aristokant2027/bot/docs/preview_three_quarter.png

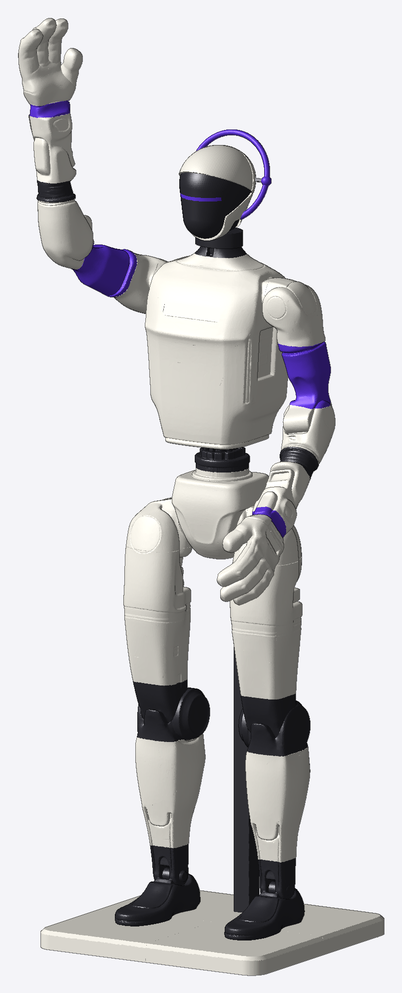
docs/preview_three_quarter.png
