aristokant2027/bot/stl/1_white/head_cheek.stl

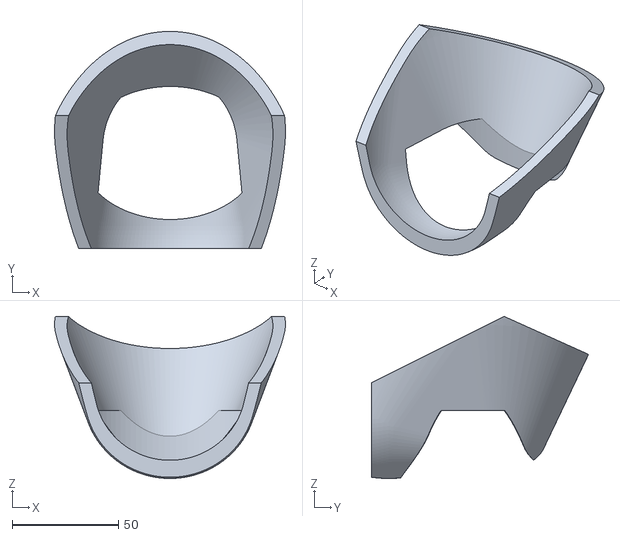
[picture p5: CAD file, 2026-11-12]
stl/1_white/head_cheek.stl
108.7 x 102.2 x 76.3
