aristokant2027/bot/stl/2_black/head.stl

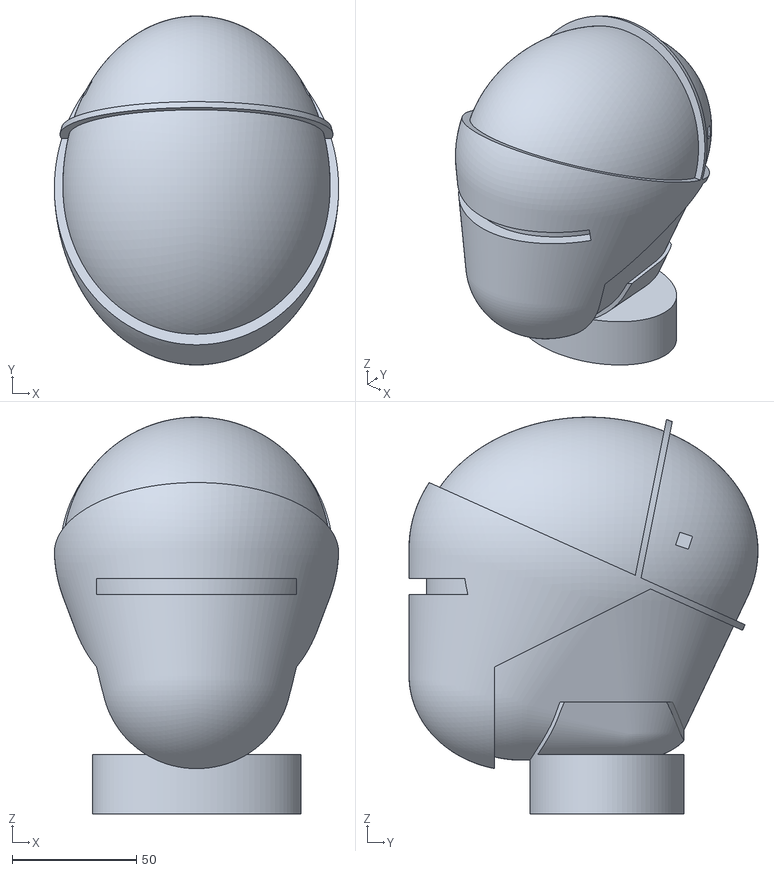
[picture p6: CAD file, 2026-11-12]
stl/2_black/head.stl
114.5 x 140.5 x 159.8
