aristokant2027/bot/stl/3_purple/head_eye.stl

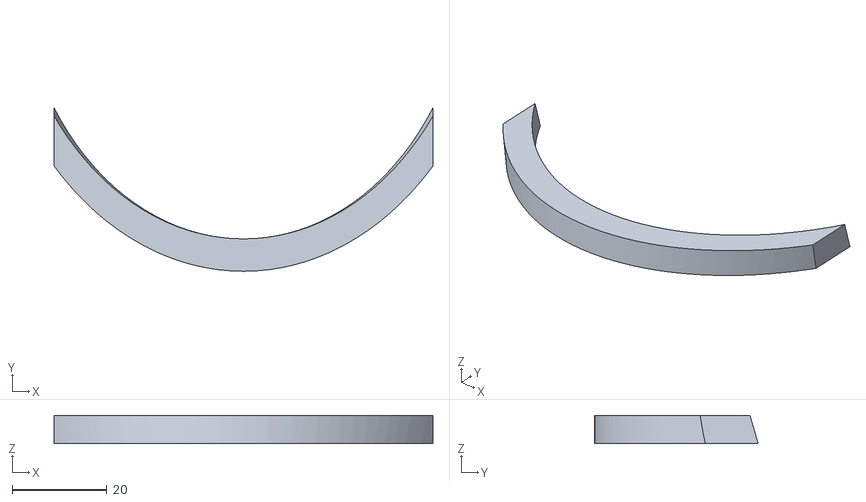
[picture p7: CAD file, 2026-11-12]
stl/3_purple/head_eye.stl
80.0 x 34.5 x 6.00
