aristokant2027/bot/stl/4_connectors/tenon_T16x89.stl

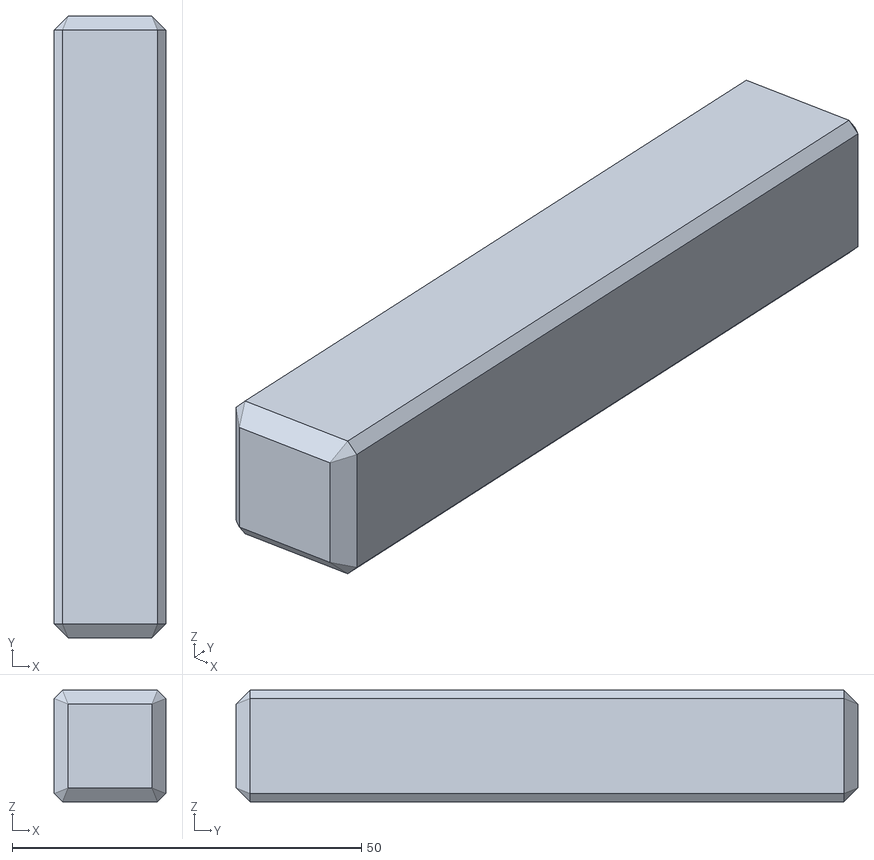
[picture p8: CAD file, 2026-11-12]
stl/4_connectors/tenon_T16x89.stl
16.0 x 89.0 x 16.0
