aristokant2027/bot/stl/1_white/head_cap_f.stl

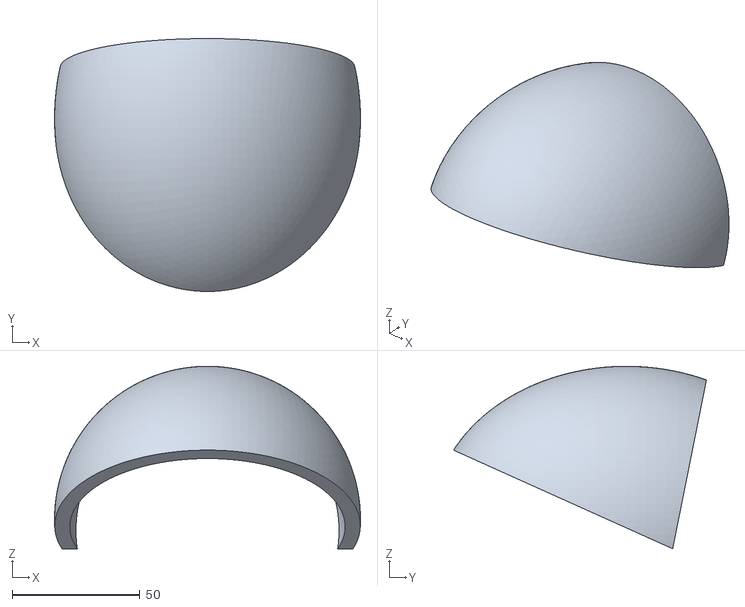
[picture p9: CAD file, 2026-11-12]
stl/1_white/head_cap_f.stl
120.0 x 99.2 x 71.6
