aristokant2027/bot/stl/2_black/halo_strut_L.stl

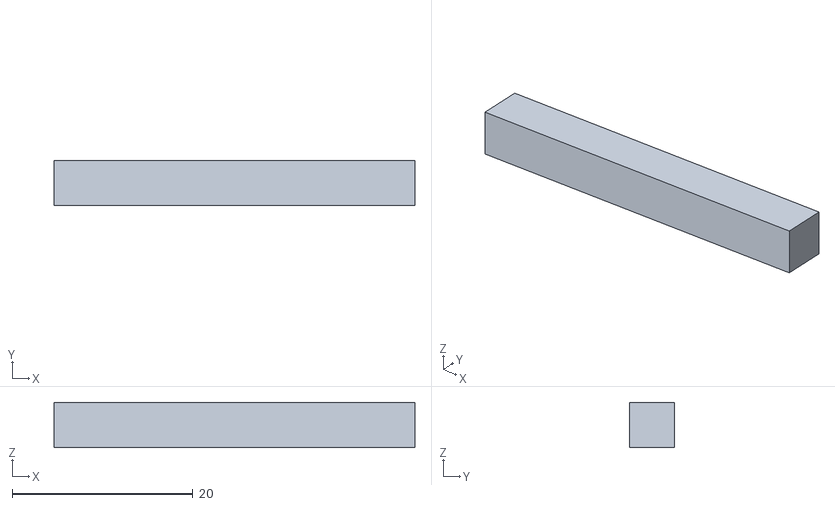
[picture p10: CAD file, 2026-11-12]
stl/2_black/halo_strut_L.stl
40.0 x 5.00 x 5.00
