aristokant2027/bot/stl/3_purple/halo.stl

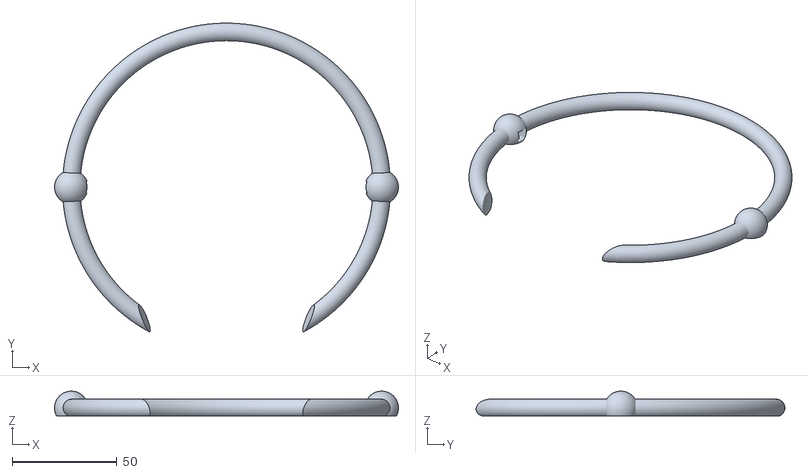
[picture p11: CAD file, 2026-11-12]
stl/3_purple/halo.stl
164.0 x 147.2 x 11.8
