aristokant2027/bot/stl/4_connectors/fit_test_coupon.stl

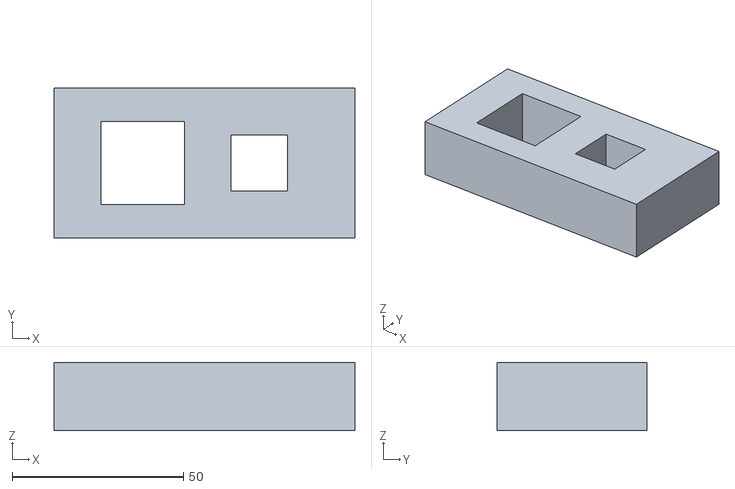
[picture p12: CAD file, 2026-11-11]
stl/4_connectors/fit_test_coupon.stl
88.0 x 44.0 x 20.0
