aristokant2027/bot/stl/1_white/head_cap_r.stl

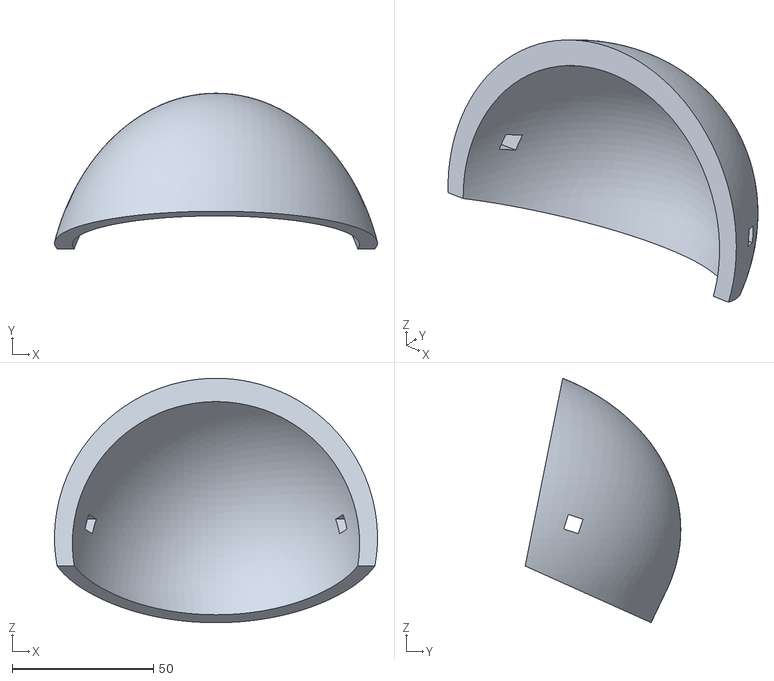
[picture p13: CAD file, 2026-11-12]
stl/1_white/head_cap_r.stl
114.2 x 55.0 x 86.4
