aristokant2027/bot/stl/3_purple/sleeve_L.stl

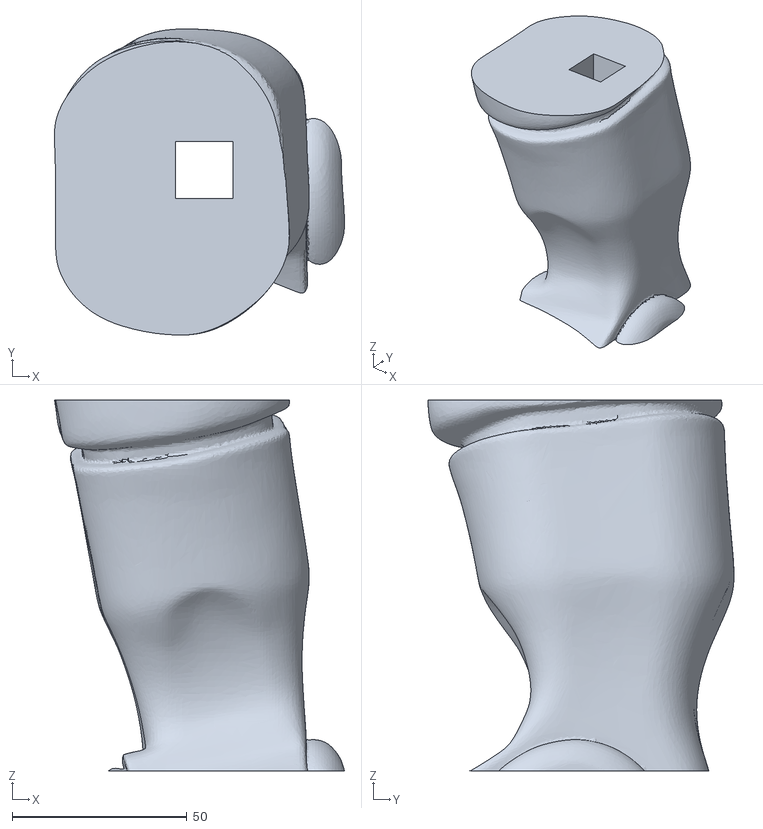
[picture p14: CAD file, 2026-11-11]
stl/3_purple/sleeve_L.stl
82.9 x 87.5 x 106.0
