aristokant2027/bot/stl/4_connectors/tenon_T16x76.stl

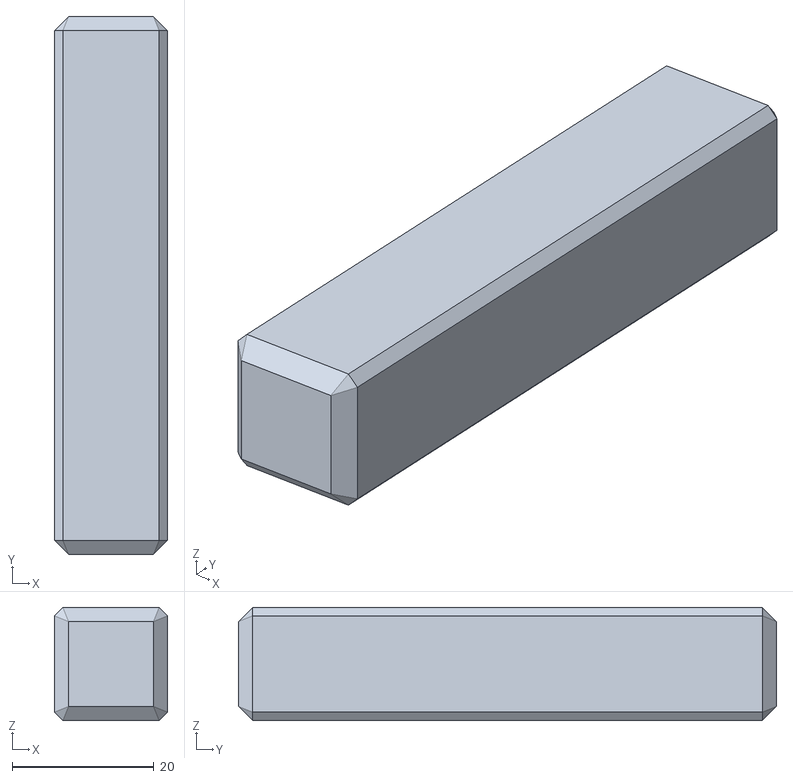
[picture p15: CAD file, 2026-11-11]
stl/4_connectors/tenon_T16x76.stl
16.0 x 76.0 x 16.0
