aristokant2027/bot/stl/1_white/torso.stl

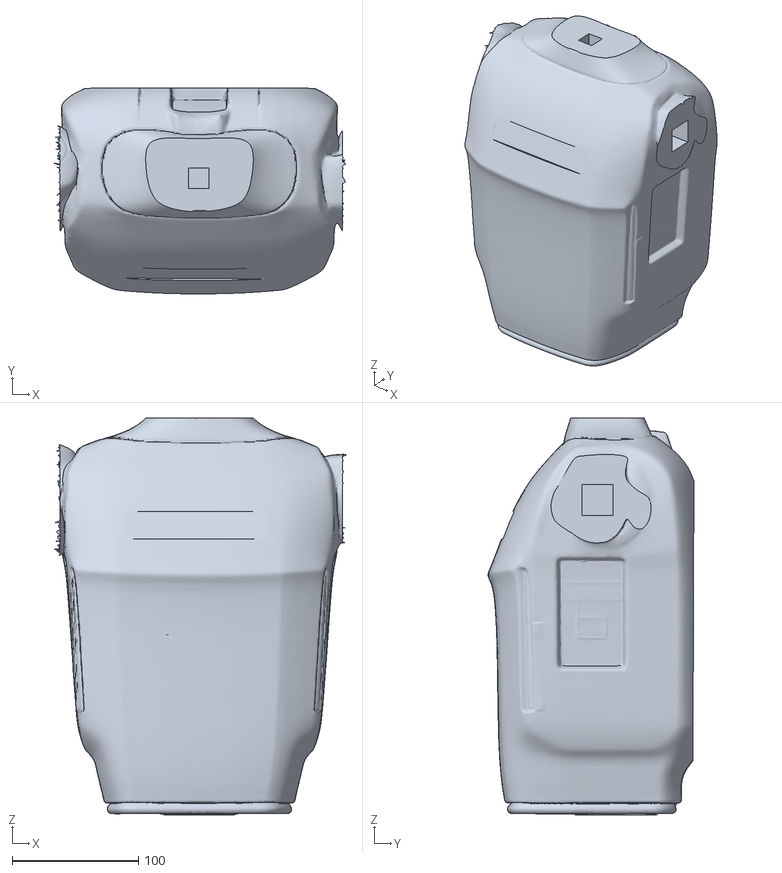
[picture p16: CAD file, 2026-11-12]
stl/1_white/torso.stl
231.3 x 163.4 x 315.0
