aristokant2027/bot/stl/2_black/neck.stl

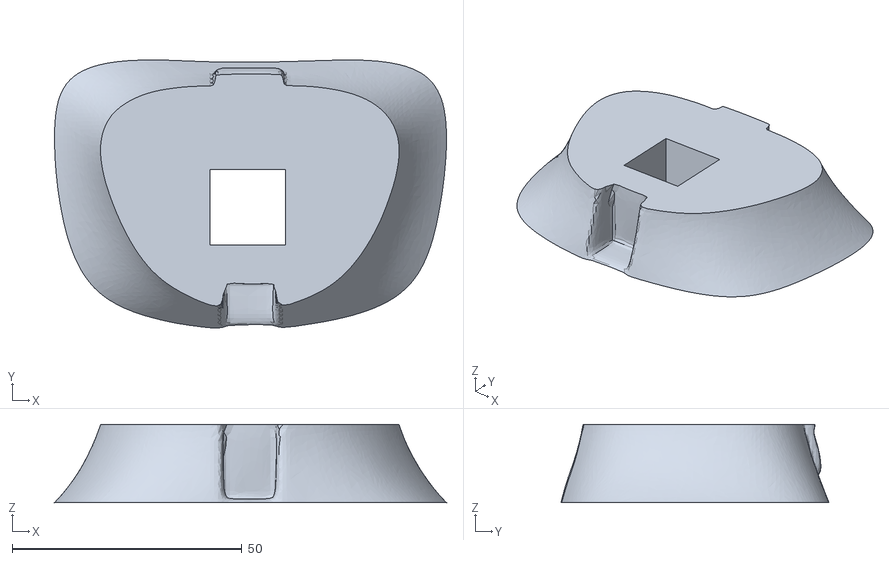
[picture p17: CAD file, 2026-11-12]
stl/2_black/neck.stl
85.4 x 58.4 x 17.0
