aristokant2027/bot/stl/3_purple/wrist_L.stl

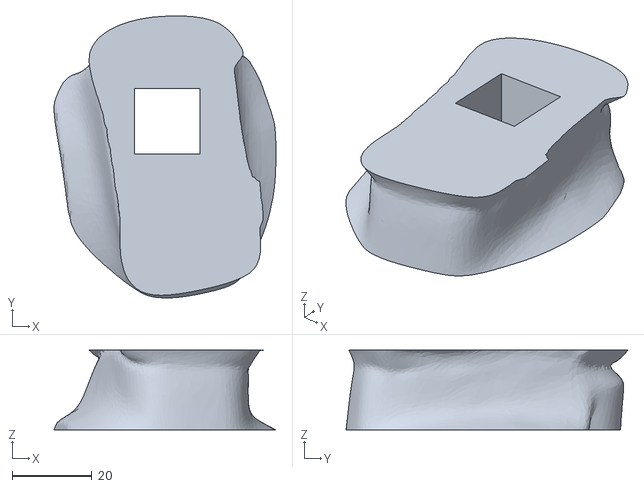
[picture p18: CAD file, 2026-11-11]
stl/3_purple/wrist_L.stl
55.5 x 70.5 x 20.0
