aristokant2027/bot/stl/4_connectors/tenon_T24x101.stl

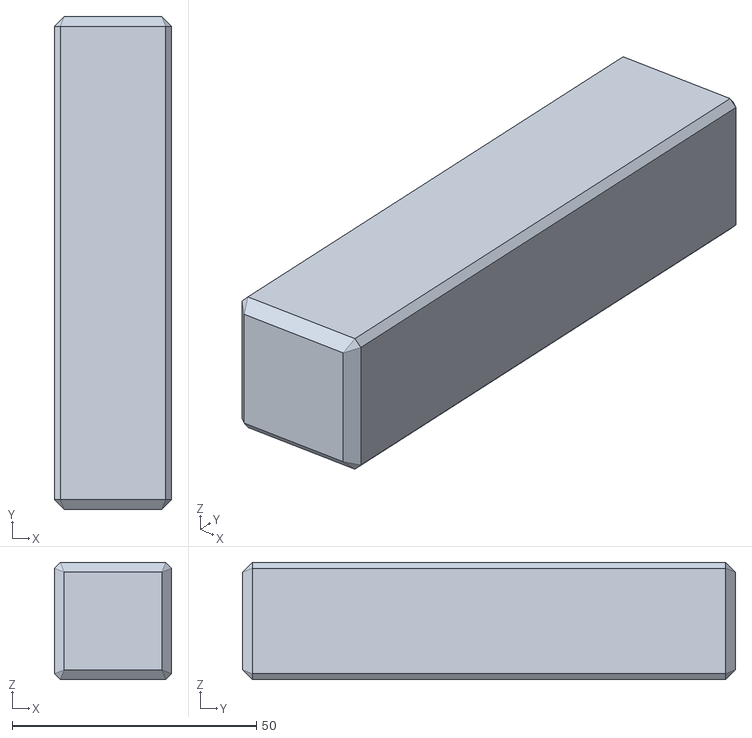
[picture p19: CAD file, 2026-11-11]
stl/4_connectors/tenon_T24x101.stl
24.0 x 101.0 x 24.0
