aristokant2027/bot/stl/1_white/pelvis.stl

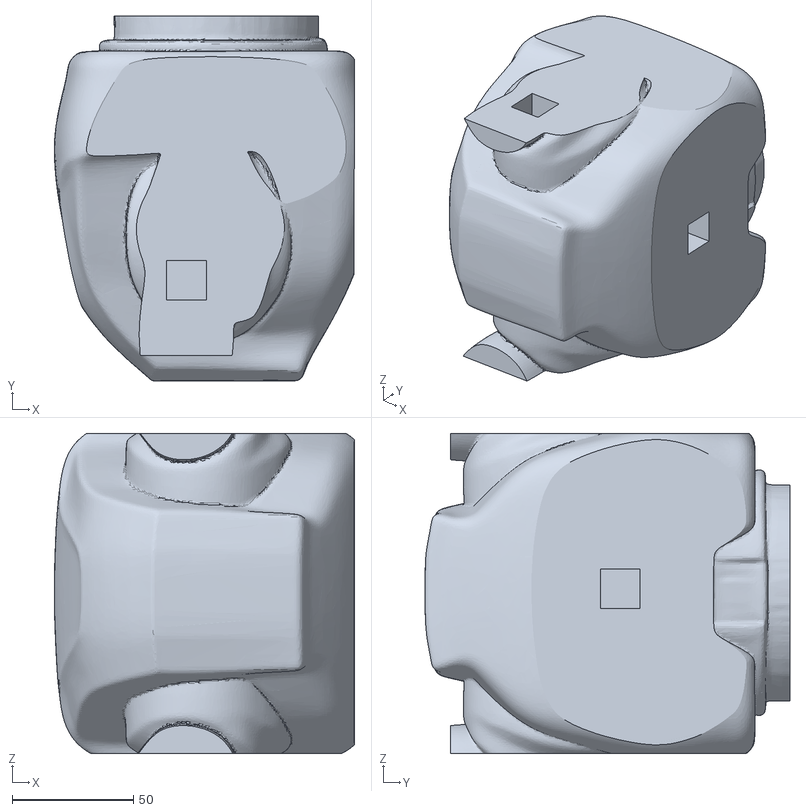
[picture p20: CAD file, 2026-11-11]
stl/1_white/pelvis.stl
123.9 x 150.6 x 132.0
