aristokant2027/bot/stl/2_black/waistcol.stl

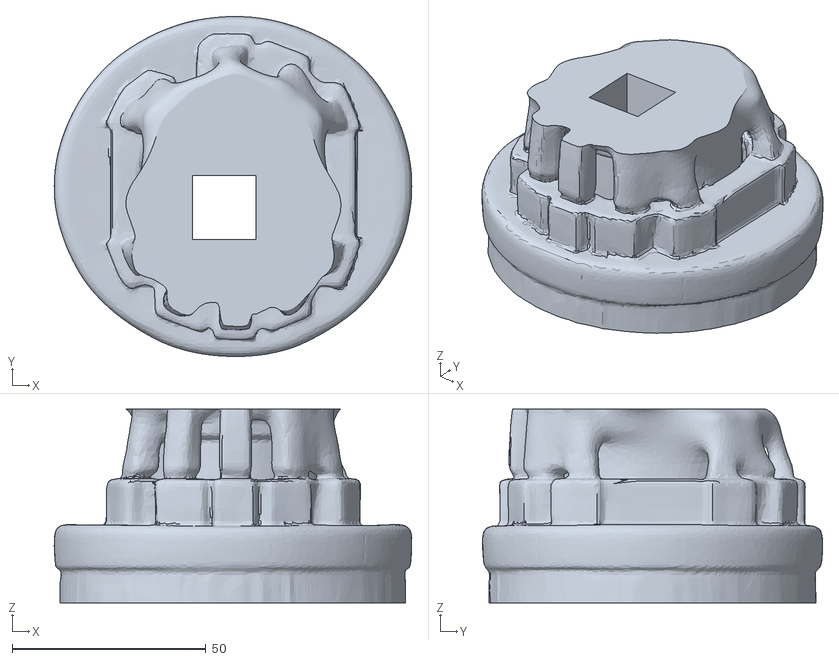
[picture p21: CAD file, 2026-11-11]
stl/2_black/waistcol.stl
92.2 x 87.7 x 50.0
