aristokant2027/bot/stl/3_purple/sleeve_R.stl

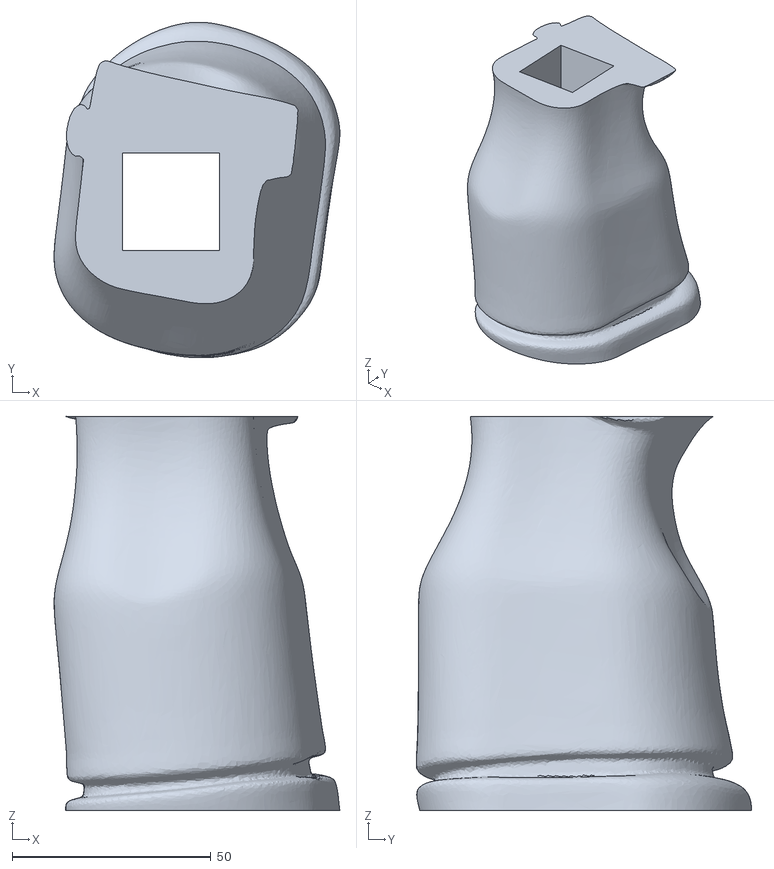
[picture p22: CAD file, 2026-11-11]
stl/3_purple/sleeve_R.stl
71.8 x 84.3 x 99.0
