aristokant2027/bot/stl/4_connectors/tenon_T24x67.stl

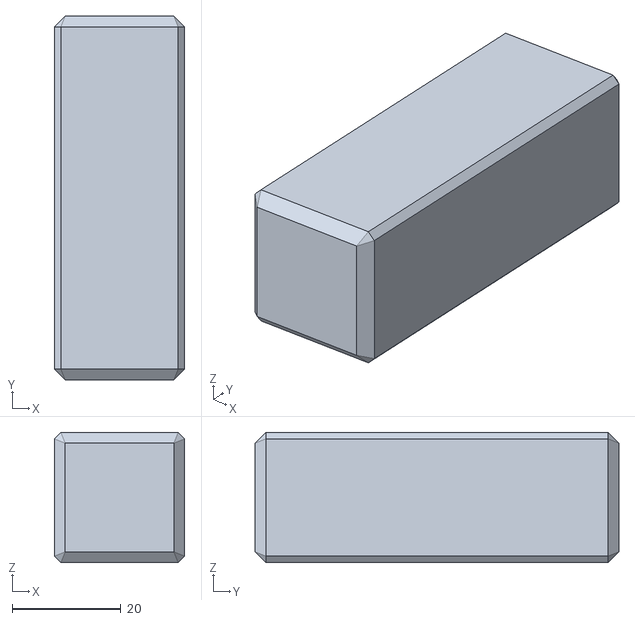
[picture p23: CAD file, 2026-11-11]
stl/4_connectors/tenon_T24x67.stl
24.0 x 67.0 x 24.0
