aristokant2027/bot/stl/1_white/hip_R.stl

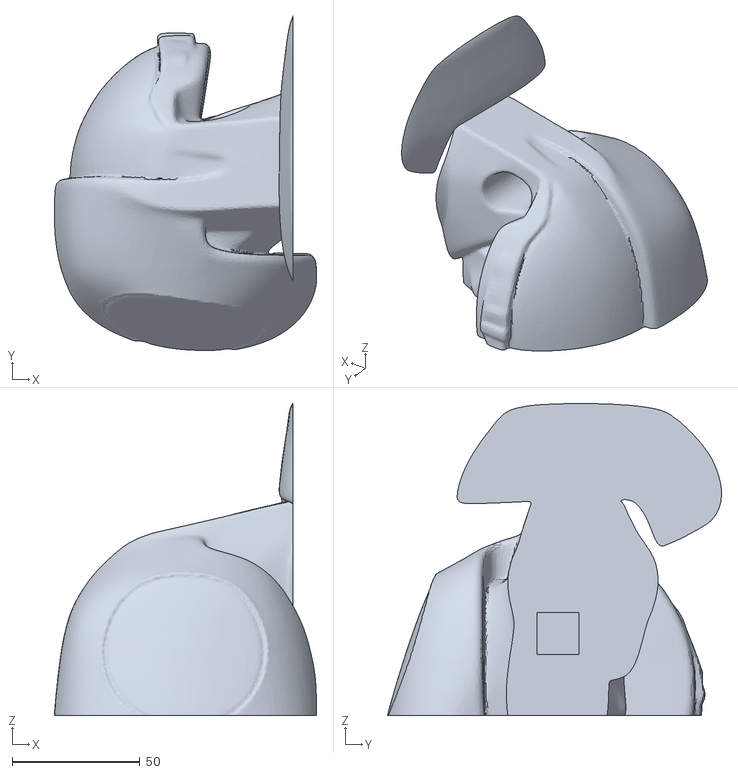
[picture p24: CAD file, 2026-11-11]
stl/1_white/hip_R.stl
102.5 x 130.6 x 122.0
