aristokant2027/bot/stl/2_black/ring_R.stl

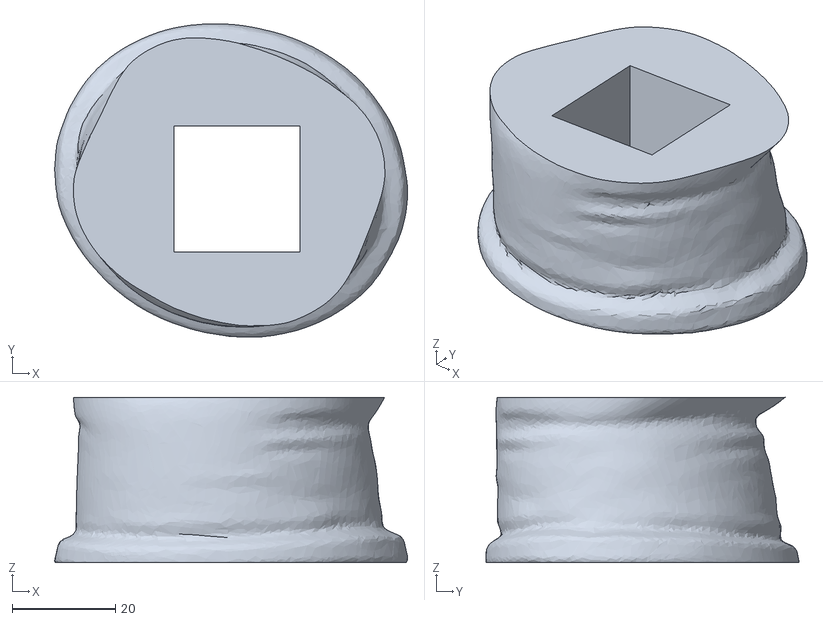
[picture p25: CAD file, 2026-11-11]
stl/2_black/ring_R.stl
68.3 x 60.7 x 32.0
