aristokant2027/bot/stl/3_purple/wrist_R.stl

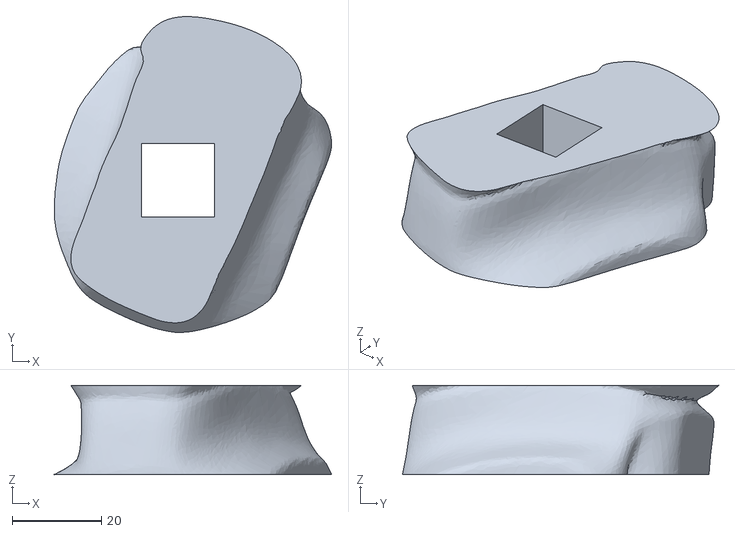
[picture p26: CAD file, 2026-11-11]
stl/3_purple/wrist_R.stl
62.2 x 70.9 x 20.0
