aristokant2027/bot/stl/4_connectors/tenon_T24x69.stl

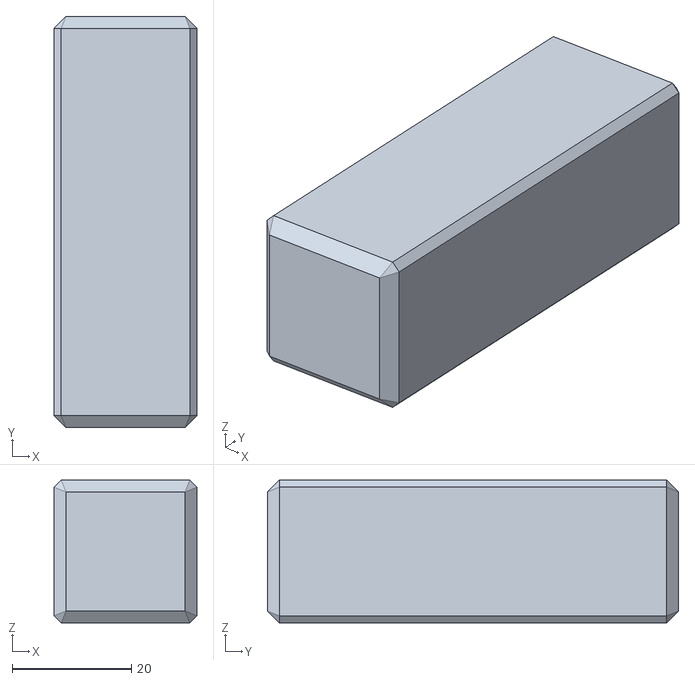
[picture p27: CAD file, 2026-11-11]
stl/4_connectors/tenon_T24x69.stl
24.0 x 69.0 x 24.0
