aristokant2027/bot/stl/1_white/thigh_R.stl

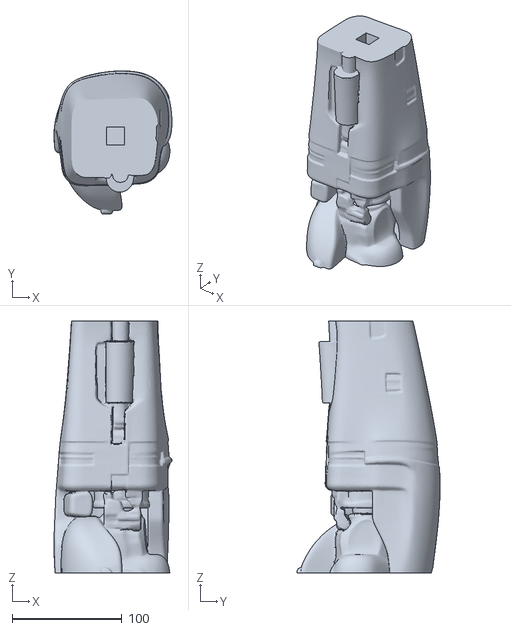
[picture p28: CAD file, 2026-11-11]
stl/1_white/thigh_R.stl
107.6 x 130.7 x 230.0
