aristokant2027/bot/stl/2_black/knee_L.stl

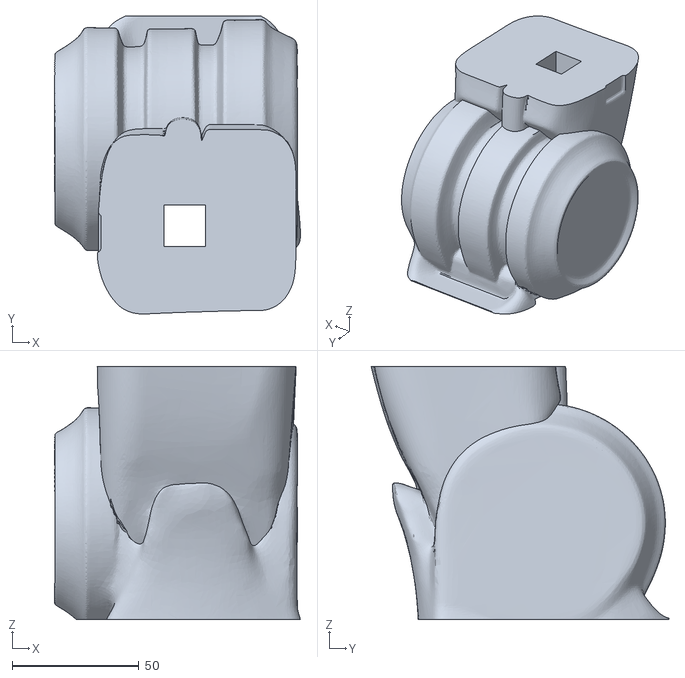
[picture p29: CAD file, 2026-11-11]
stl/2_black/knee_L.stl
97.1 x 117.6 x 100.0
