aristokant2027/bot/stl/4_connectors/tenon_T16x44.stl

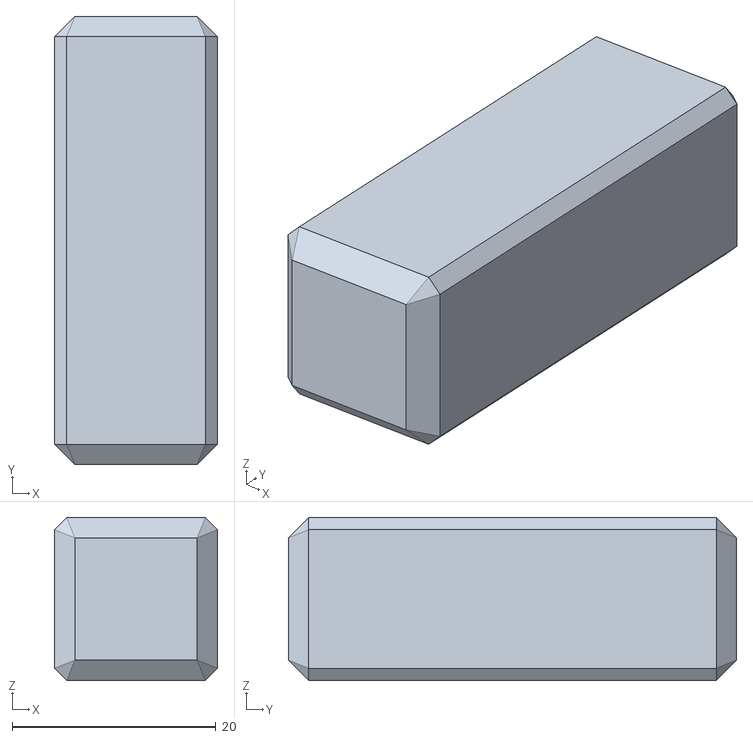
[picture p30: CAD file, 2026-11-11]
stl/4_connectors/tenon_T16x44.stl
16.0 x 44.0 x 16.0
