aristokant2027/bot/stl/1_white/shoulder_L.stl

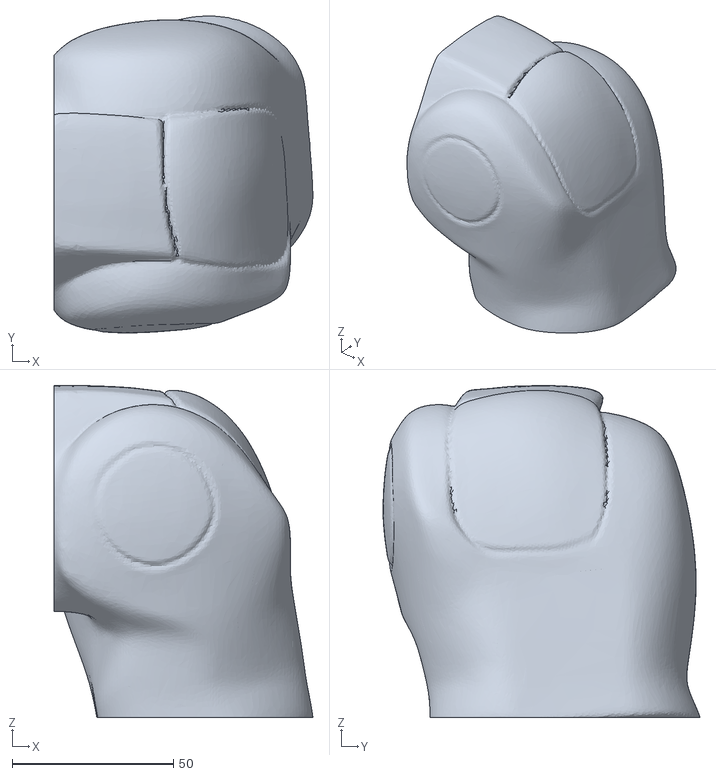
[picture p31: CAD file, 2026-11-11]
stl/1_white/shoulder_L.stl
80.3 x 98.4 x 103.1
