aristokant2027/bot/stl/2_black/post_3.stl

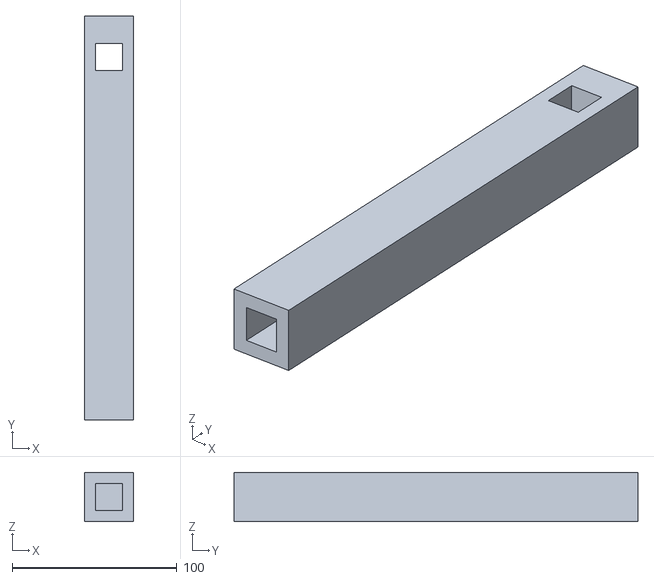
[picture p32: CAD file, 2026-11-11]
stl/2_black/post_3.stl
30.0 x 245.0 x 30.0
