aristokant2027/bot/stl/4_connectors/tenon_T16x69.stl

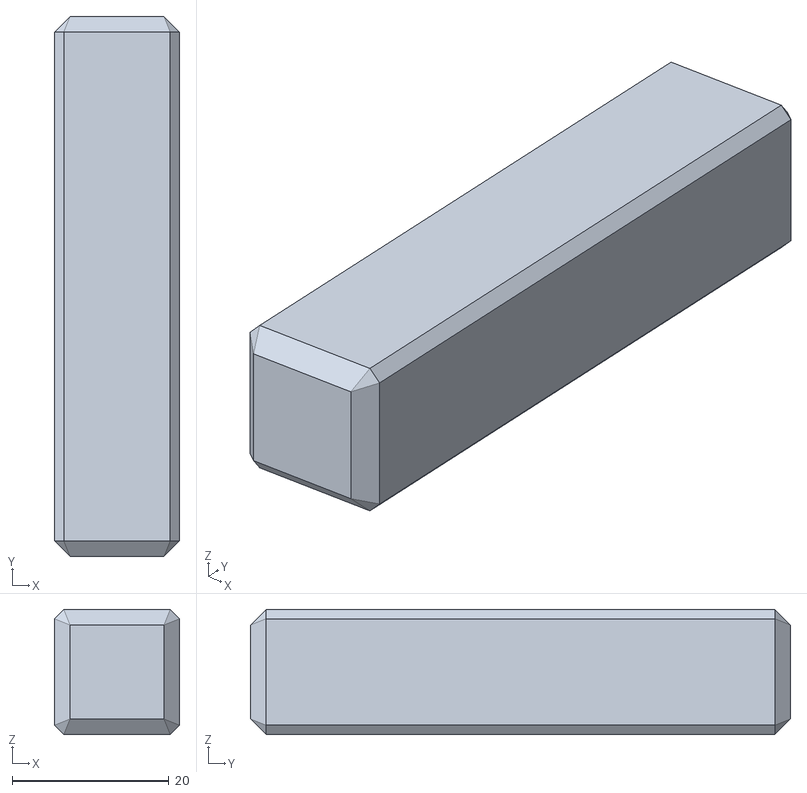
[picture p33: CAD file, 2026-11-11]
stl/4_connectors/tenon_T16x69.stl
16.0 x 69.0 x 16.0
