aristokant2027/bot/stl/1_white/elbow_R.stl

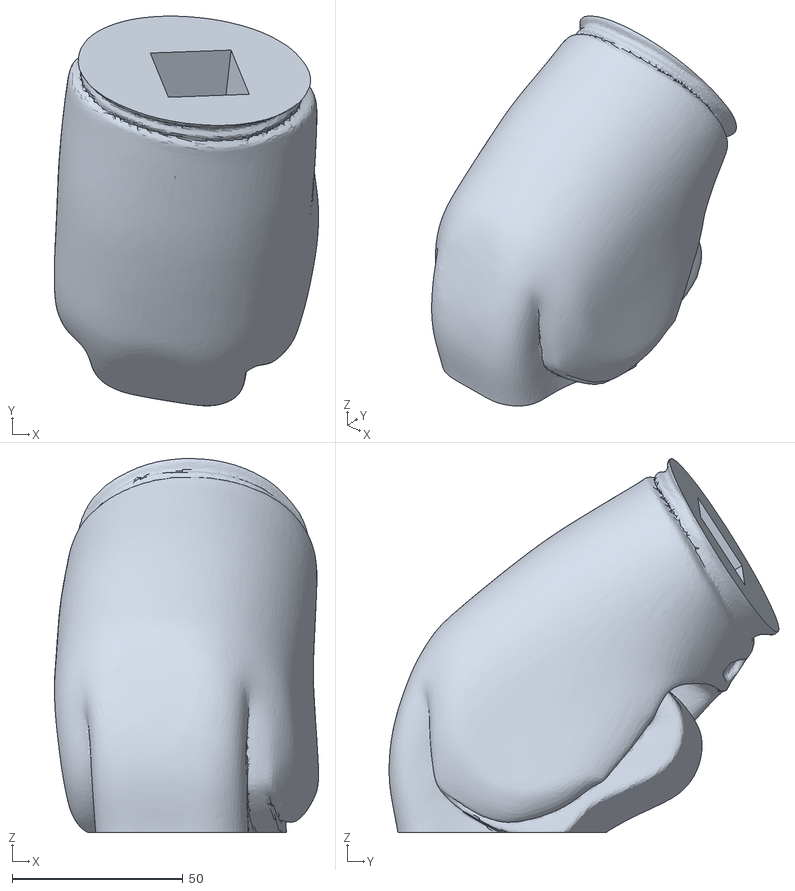
[picture p34: CAD file, 2026-11-11]
stl/1_white/elbow_R.stl
77.4 x 114.2 x 109.6
