aristokant2027/bot/stl/2_black/ring_L.stl

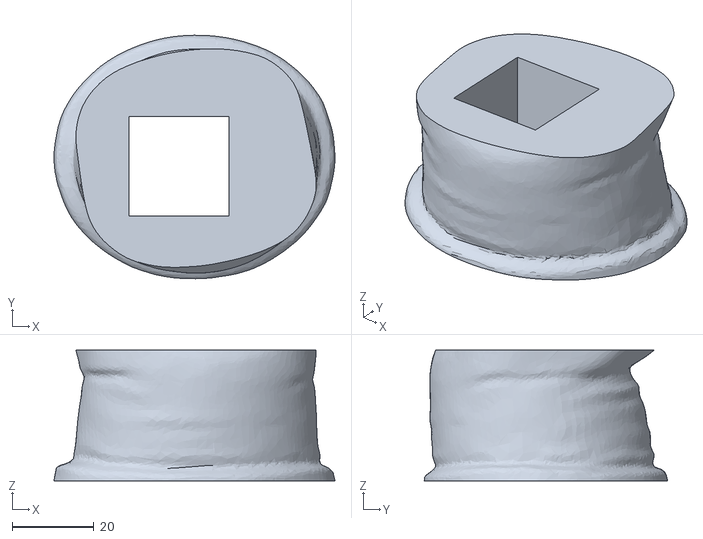
[picture p35: CAD file, 2026-11-11]
stl/2_black/ring_L.stl
68.8 x 59.6 x 32.0
