aristokant2027/bot/stl/4_connectors/bowtie_key.stl

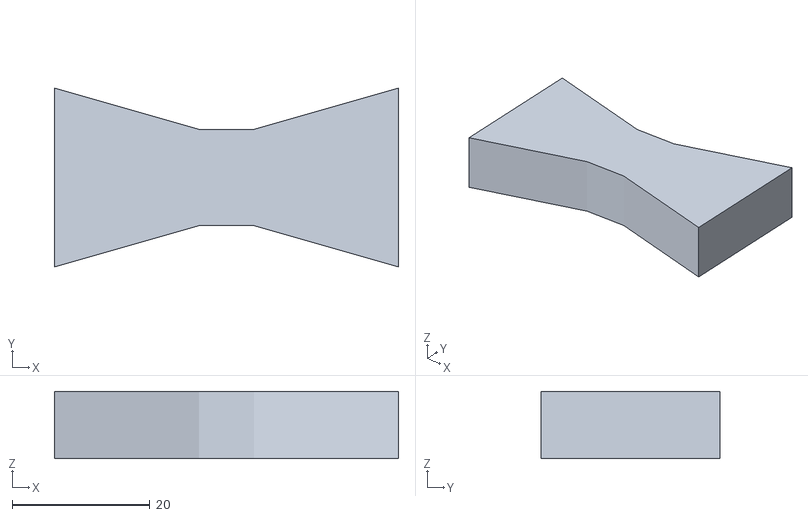
[picture p36: CAD file, 2026-11-11]
stl/4_connectors/bowtie_key.stl
50.0 x 26.0 x 9.80
