aristokant2027/bot/stl/1_white/hand_L.stl

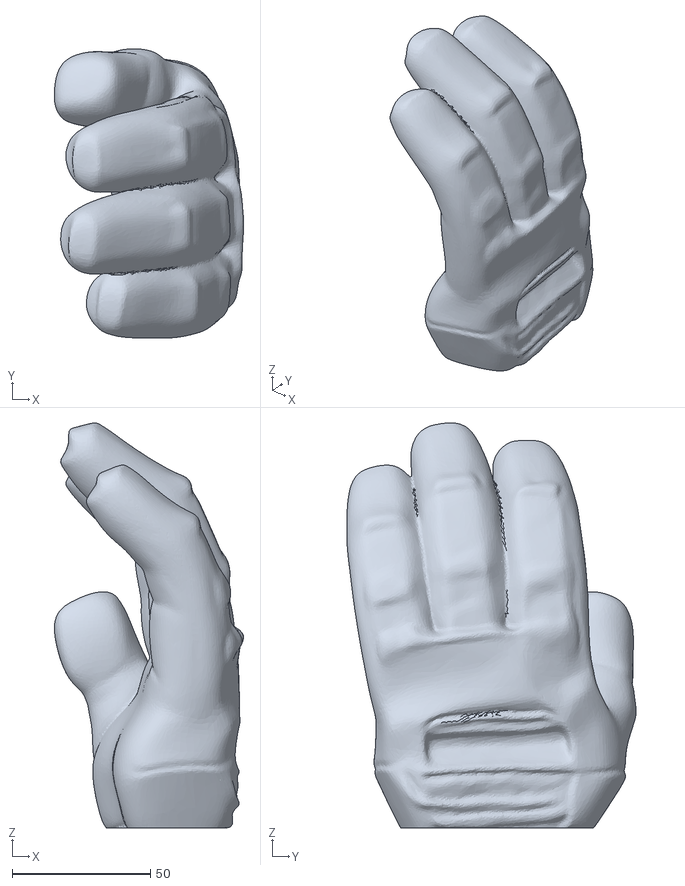
[picture p37: CAD file, 2026-11-11]
stl/1_white/hand_L.stl
68.6 x 104.8 x 146.7
