aristokant2027/bot/stl/2_black/foot_L.stl

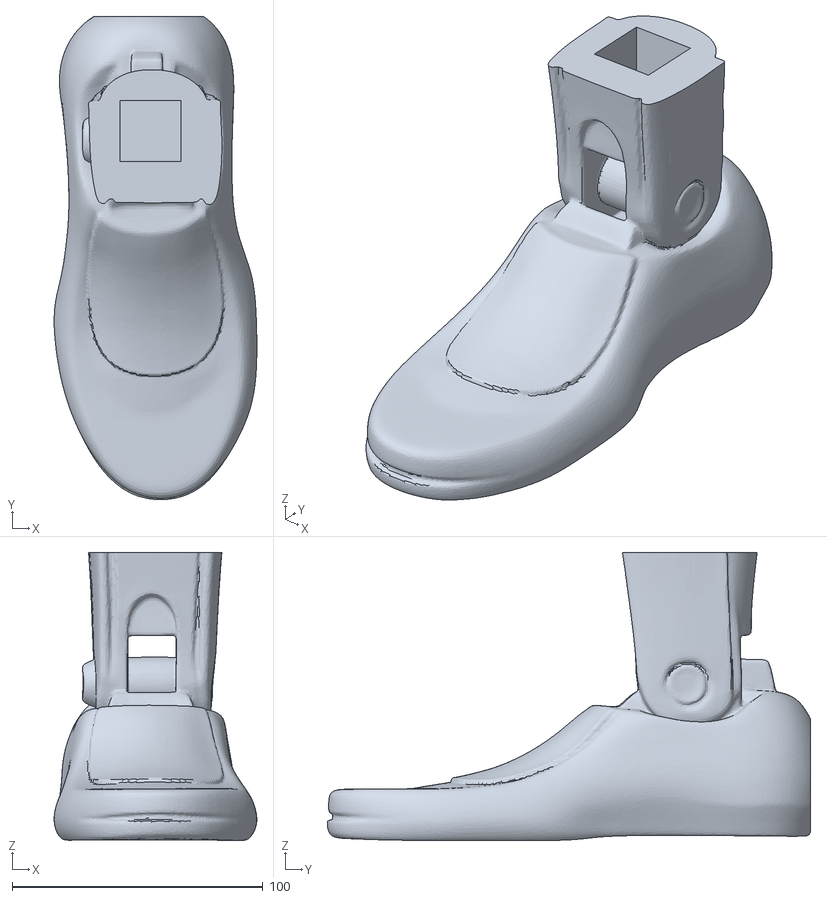
[picture p38: CAD file, 2026-11-11]
stl/2_black/foot_L.stl
80.9 x 193.0 x 115.0
