aristokant2027/bot/stl/4_connectors/tenon_T16x175.stl

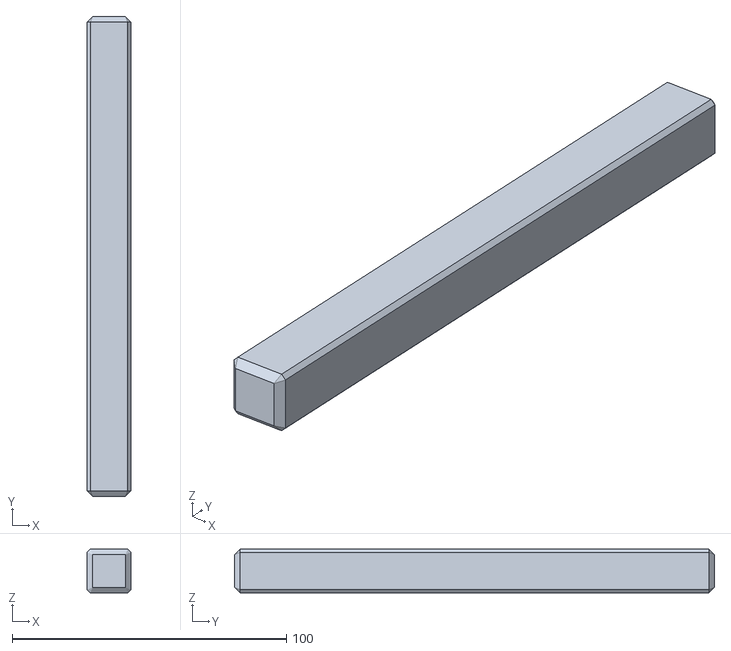
[picture p39: CAD file, 2026-11-11]
stl/4_connectors/tenon_T16x175.stl
16.0 x 175.0 x 16.0
