aristokant2027/bot/stl/1_white/shin_R.stl

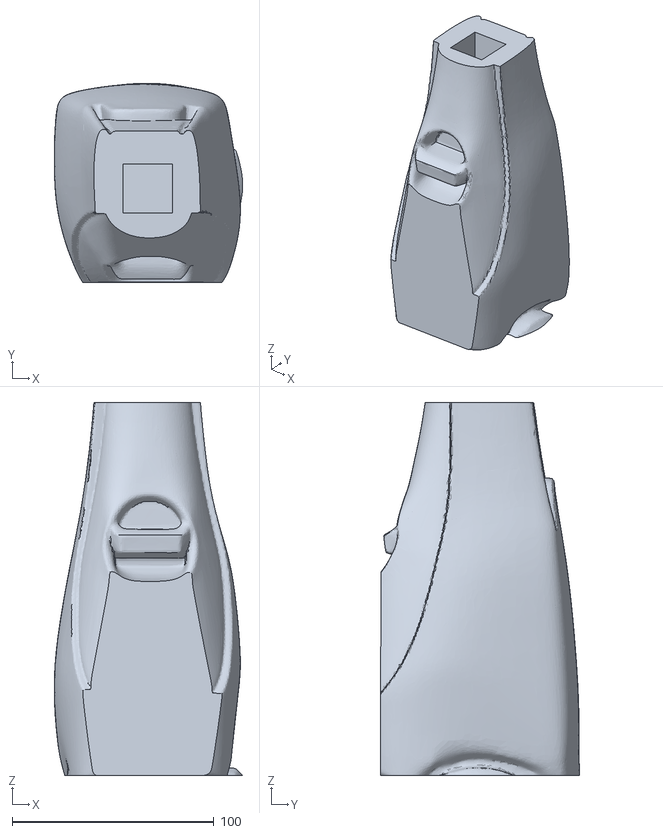
[picture p40: CAD file, 2026-11-11]
stl/1_white/shin_R.stl
93.5 x 98.9 x 185.0
