aristokant2027/bot/stl/2_black/knee_R.stl

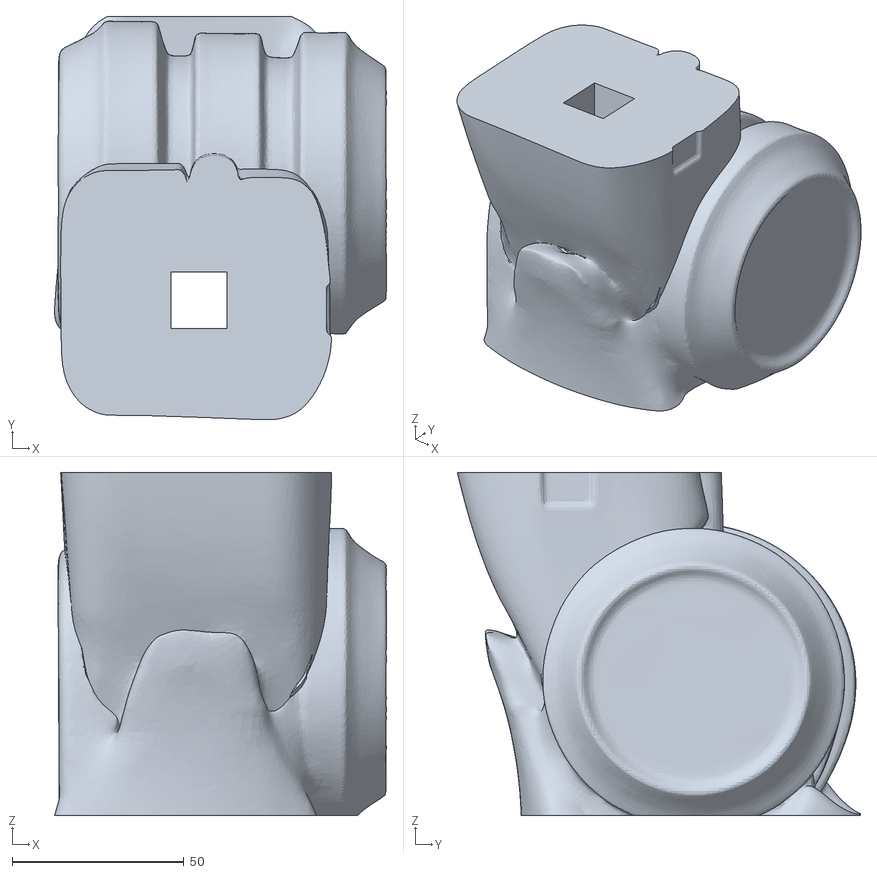
[picture p41: CAD file, 2026-11-11]
stl/2_black/knee_R.stl
96.7 x 117.5 x 100.0
