aristokant2027/bot/stl/4_connectors/tenon_T16x139.stl

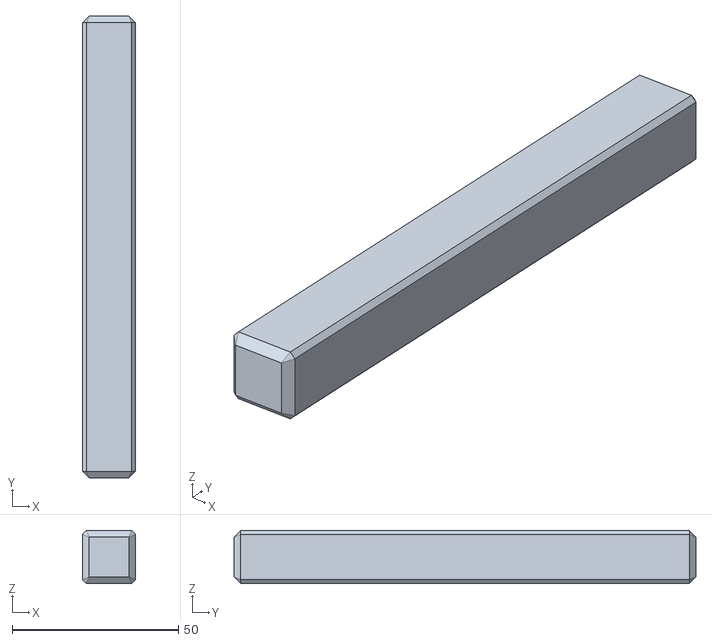
[picture p42: CAD file, 2026-11-11]
stl/4_connectors/tenon_T16x139.stl
16.0 x 139.0 x 16.0
