aristokant2027/bot/stl/1_white/forearm_L.stl

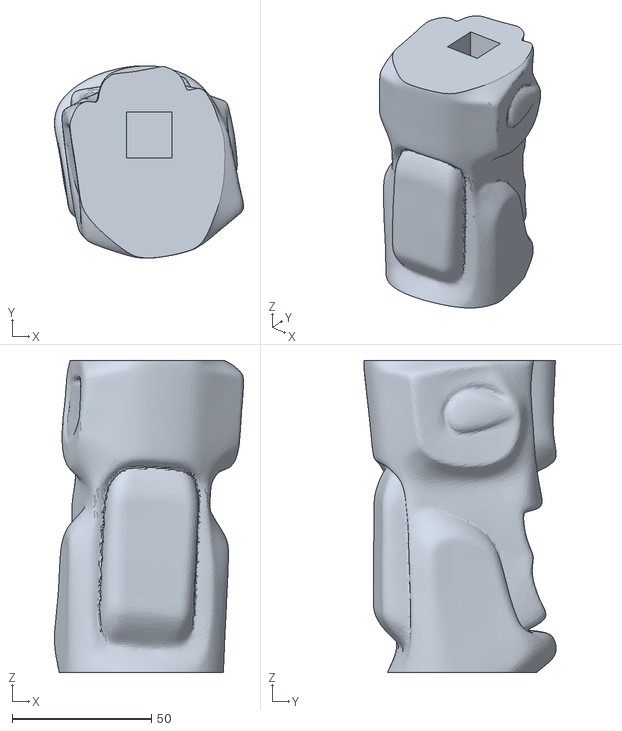
[picture p43: CAD file, 2026-11-11]
stl/1_white/forearm_L.stl
67.9 x 69.0 x 112.0
