aristokant2027/bot/stl/4_connectors/tenon_T24x168.stl

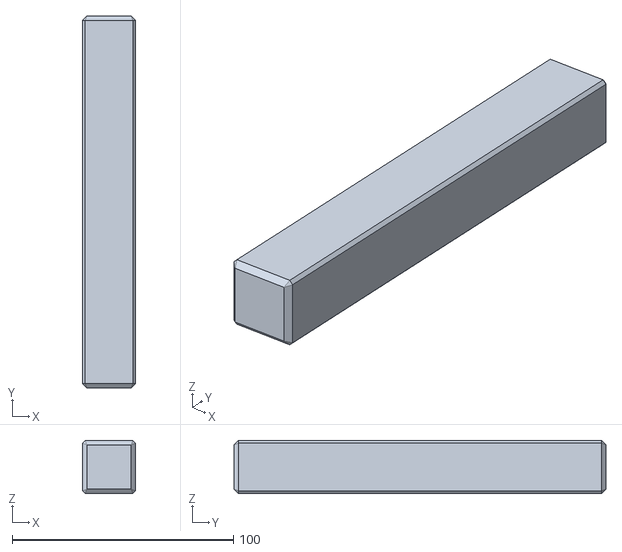
[picture p44: CAD file, 2026-11-11]
stl/4_connectors/tenon_T24x168.stl
24.0 x 168.0 x 24.0
