aristokant2027/bot/stl/1_white/elbow_L.stl

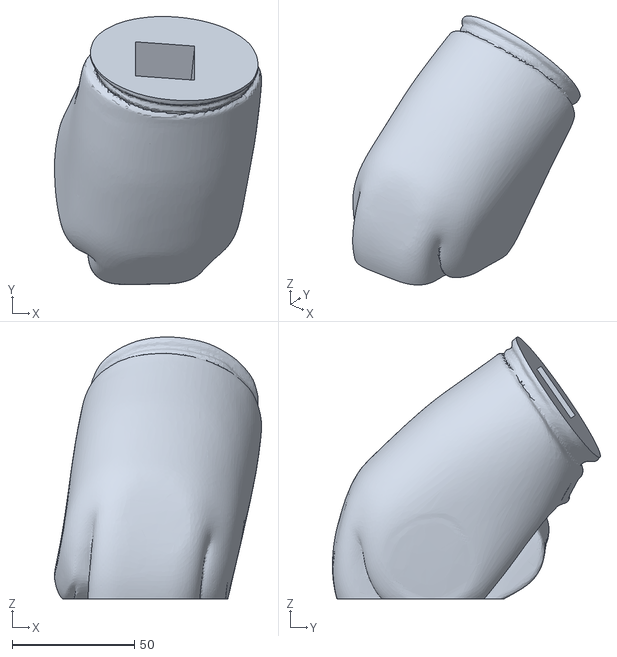
[picture p45: CAD file, 2026-11-11]
stl/1_white/elbow_L.stl
84.6 x 109.5 x 107.0
