aristokant2027/bot/stl/2_black/foot_R.stl

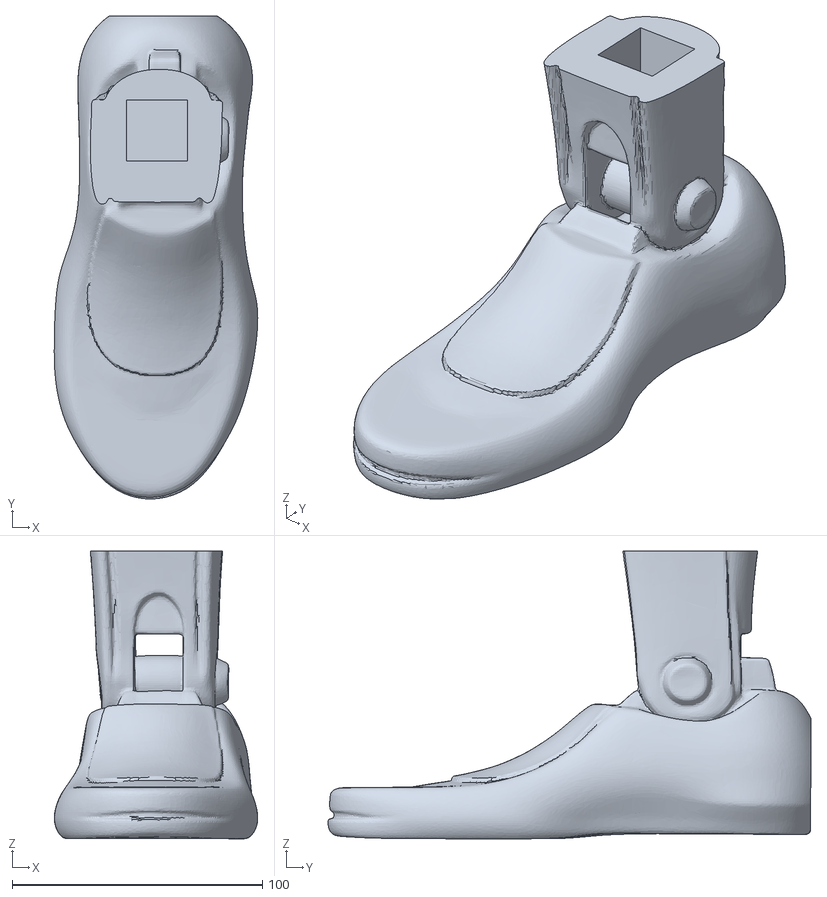
[picture p46: CAD file, 2026-11-11]
stl/2_black/foot_R.stl
81.3 x 193.0 x 115.0
