aristokant2027/bot/stl/4_connectors/tenon_T16x84.stl

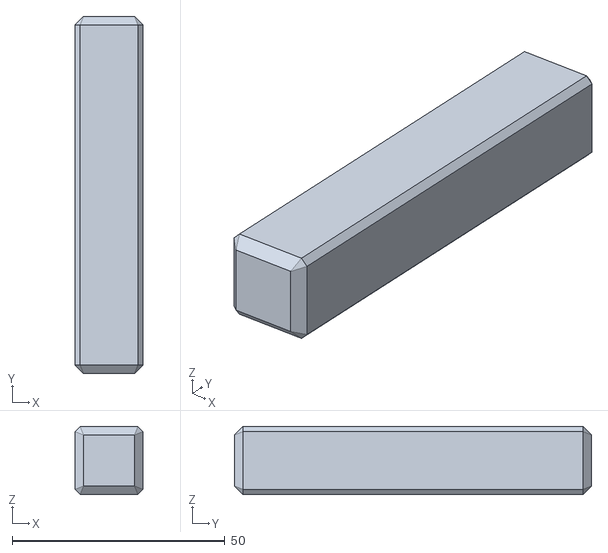
[picture p47: CAD file, 2026-11-11]
stl/4_connectors/tenon_T16x84.stl
16.0 x 84.0 x 16.0
