aristokant2027/bot/stl/1_white/shoulder_R.stl

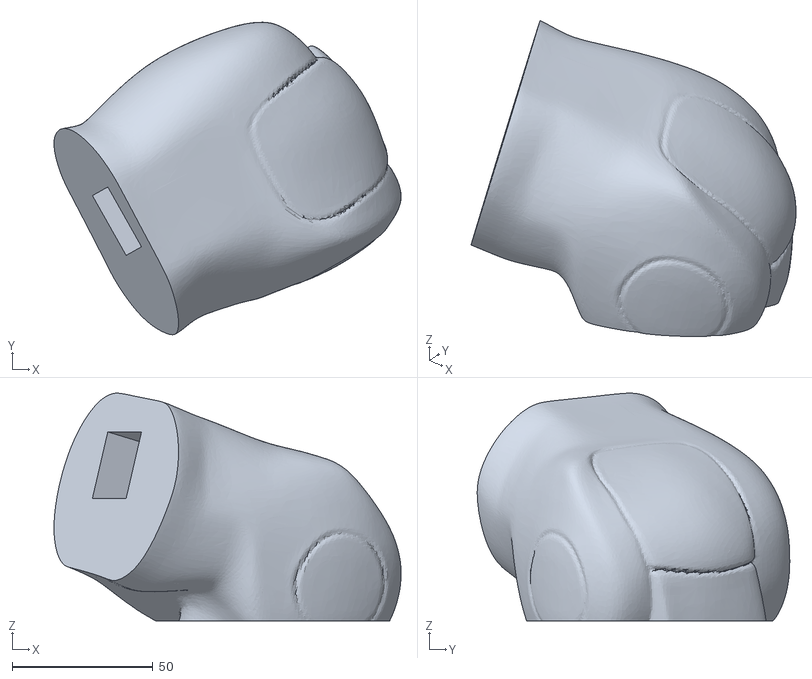
[picture p48: CAD file, 2026-11-11]
stl/1_white/shoulder_R.stl
123.3 x 111.1 x 80.9
