aristokant2027/bot/stl/4_connectors/tenon_T24x79.stl

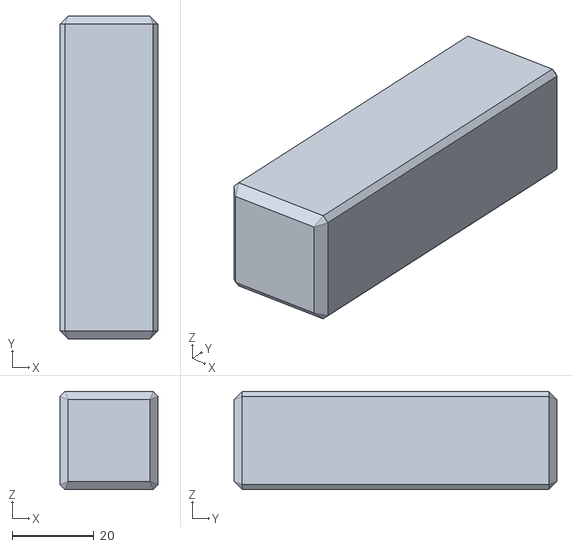
[picture p49: CAD file, 2026-11-11]
stl/4_connectors/tenon_T24x79.stl
24.0 x 79.0 x 24.0
