aristokant2027/bot/stl/1_white/forearm_R.stl

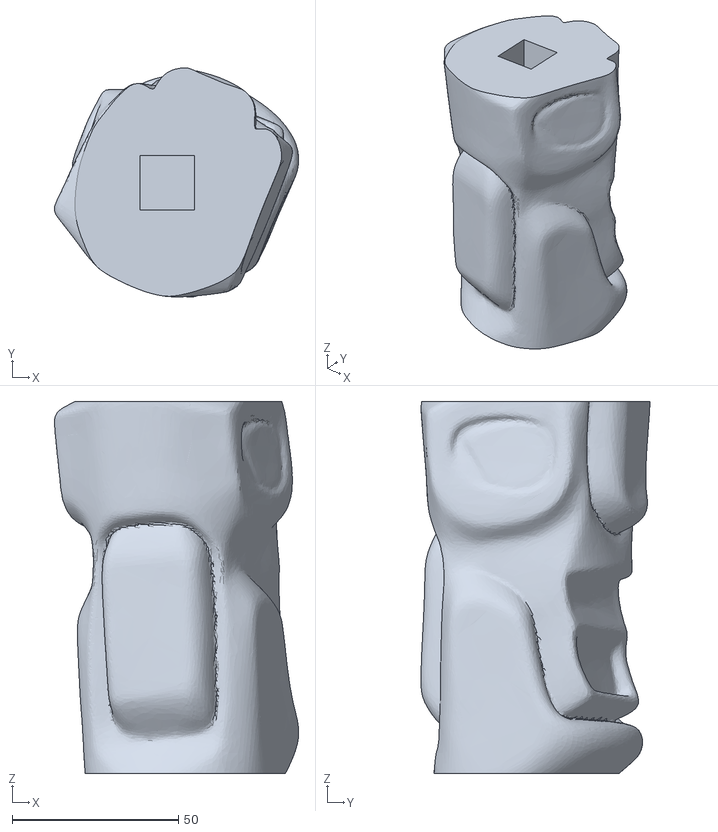
[picture p50: CAD file, 2026-11-11]
stl/1_white/forearm_R.stl
73.5 x 69.1 x 112.0
