aristokant2027/bot/stl/4_connectors/tenon_T16x59.stl

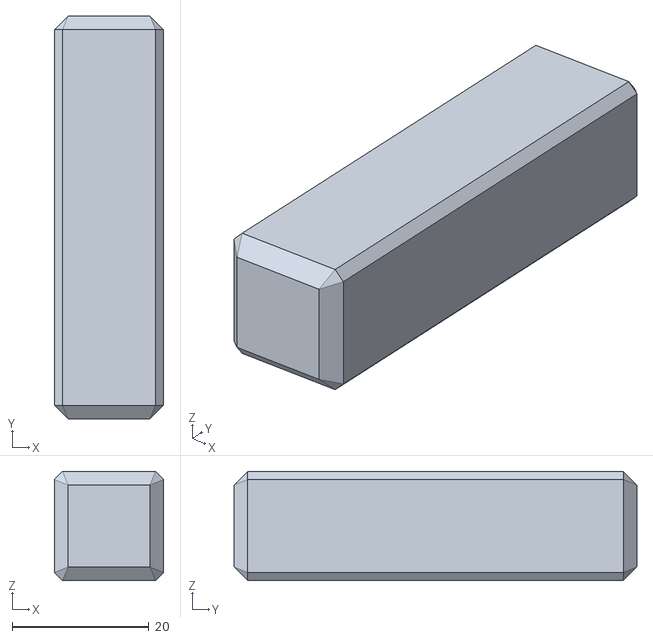
[picture p51: CAD file, 2026-11-11]
stl/4_connectors/tenon_T16x59.stl
16.0 x 59.0 x 16.0
