aristokant2027/bot/stl/1_white/hip_L.stl

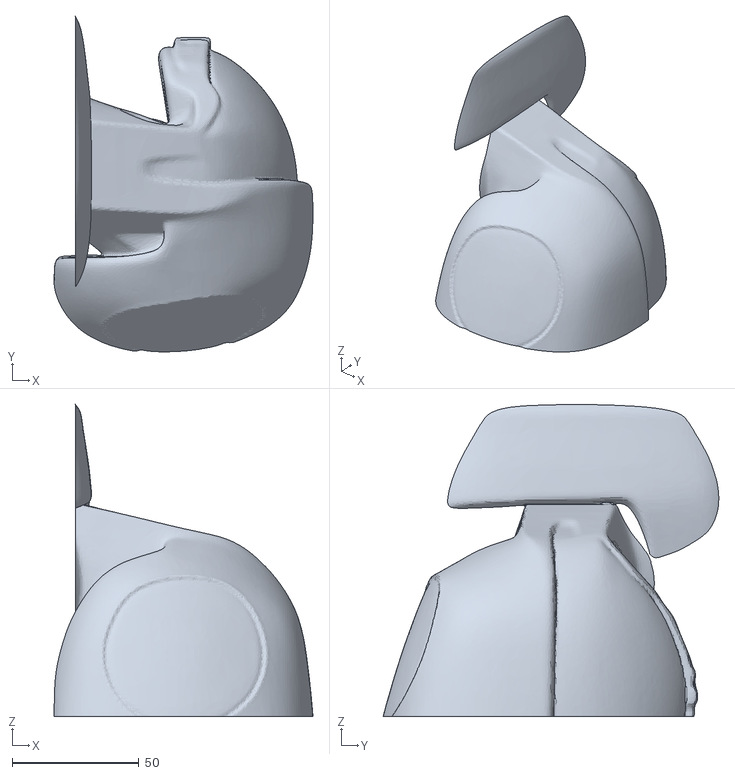
[picture p52: CAD file, 2026-11-11]
stl/1_white/hip_L.stl
102.2 x 132.6 x 123.2
