aristokant2027/bot/stl/4_connectors/tenon_T24x26.stl

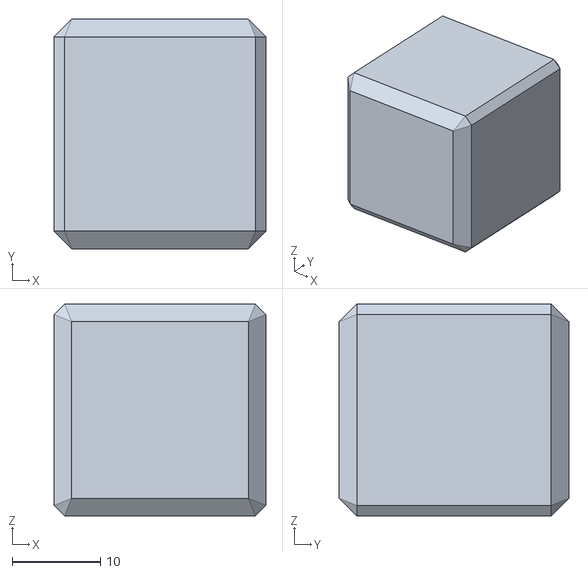
[picture p53: CAD file, 2026-11-11]
stl/4_connectors/tenon_T24x26.stl
24.0 x 26.0 x 24.0
