aristokant2027/bot/stl/1_white/hand_R.stl

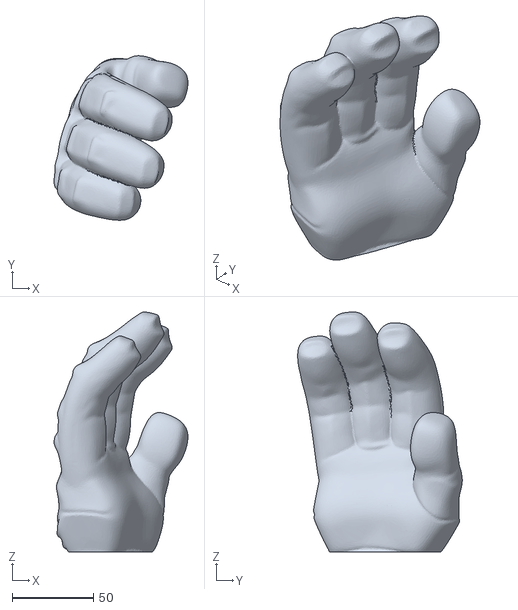
[picture p54: CAD file, 2026-11-11]
stl/1_white/hand_R.stl
82.6 x 101.6 x 148.1
