aristokant2027/bot/stl/1_white/shin_L.stl

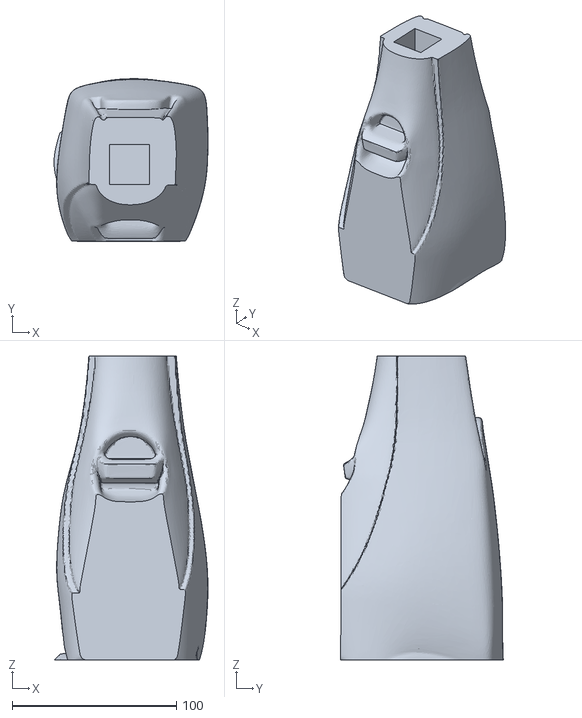
[picture p55: CAD file, 2026-11-11]
stl/1_white/shin_L.stl
93.7 x 99.0 x 185.0
