aristokant2027/bot/stl/1_white/base_front_R.stl

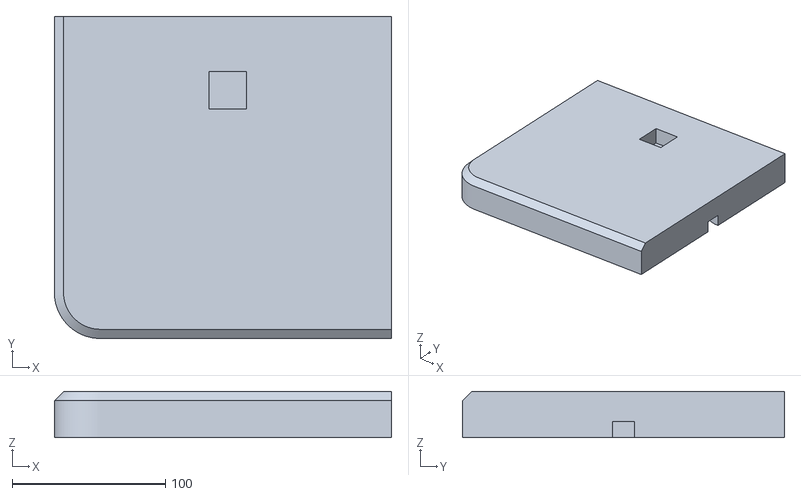
[picture p56: CAD file, 2026-11-11]
stl/1_white/base_front_R.stl
220.0 x 210.0 x 30.0
