aristokant2027/bot/(list of files, cad)

Other CAD files:
stl/1_white/thigh_L.stl
stl/2_black/post_1.stl
stl/4_connectors/tenon_T16x179.stl
stl/2_black/post_2.stl
stl/1_white/base_front_L.stl
stl/1_white/base_rear_L.stl
stl/1_white/base_rear_R.stl
