aristokant2027/bot/(commit log)

2026-11-10 Add fully printable 130 cm HUMAN+ static display figure
    Parametric generator (SDF + manifold booleans), 54 print-ready STL files
    grouped by filament colour, printed tenon/pin connectors, split base,
    previews, parts list and Chinese build guide.
    Claude-Session: https://claude.ai/code/session_012wijKV4kpQ9WPeEE2qSwv5
    [abdomen.stl, ankle_L.stl, ankle_R.stl, base_front_L.stl, base_front_R.stl, base_rear_L.stl, base_rear_R.stl, bowtie_key.stl]
2026-11-11 G1 1:1 static figure: connectors
    [bowtie_key.stl, fit_test_coupon.stl, tenon_T16x139.stl, tenon_T16x175.stl, tenon_T16x179.stl, tenon_T16x44.stl, tenon_T16x59.stl, tenon_T16x69.stl]
2026-11-11 G1 1:1 static figure: black parts
    [base_front_L.stl, base_front_R.stl, base_rear_L.stl, base_rear_R.stl, foot_L.stl, foot_R.stl, knee_L.stl, knee_R.stl]
2026-11-11 G1 1:1 static figure: silver shell parts
    [elbow_L.stl, elbow_R.stl, forearm_L.stl, forearm_R.stl, hand_L.stl, hand_R.stl, head.stl, hip_L.stl]
2026-11-11 G1 1:1 static figure: docs and previews
    [parts.csv]
2026-11-11 HUMAN+ colours: connectors
    [bowtie_key.stl, fit_test_coupon.stl, tenon_T16x139.stl, tenon_T16x175.stl, tenon_T16x179.stl, tenon_T16x44.stl, tenon_T16x59.stl, tenon_T16x69.stl]
2026-11-11 HUMAN+ colours: purple parts
    [sleeve_L.stl, sleeve_R.stl, visor_2.stl, wrist_L.stl, wrist_R.stl]
2026-11-11 HUMAN+ colours: black parts
    [foot_L.stl, foot_R.stl, knee_L.stl, knee_R.stl, neck.stl, post_1.stl, post_2.stl, post_3.stl]
2026-11-11 HUMAN+ colours: white parts with chest logo pad
    [base_front_L.stl, base_front_R.stl, base_rear_L.stl, base_rear_R.stl, elbow_L.stl, elbow_R.stl, forearm_L.stl, forearm_R.stl]
2026-11-11 HUMAN+ colours: docs and previews
    [parts.csv]
2026-11-11 README: PETG settings and printer schedule
2026-11-12 Halo head: white armour plates, torso with T16 neck socket
    [head_cap_f.stl, head_cap_r.stl, head_cheek.stl, torso.stl]
2026-11-12 Halo head: black core, neck, halo struts
    [halo_strut_L.stl, halo_strut_R.stl, head.stl, neck.stl]
2026-11-12 Halo head: purple halo ring and eye line
    [halo.stl, head_eye.stl]
2026-11-12 Neck tenon is now T16x89
    [tenon_T16x89.stl]
2026-11-12 Docs: halo head previews, parts list, slice report
    [parts.csv]
